tonatiuh369/Semaforo_Inteligente/(list of files, drawings)

Other design files:
PCB y Circuito de MultiSIM/picaxe-14-NOV20-2009-ALR.pcb
